ppe/QL_USB_Keyboard/eagle/QL_keyboard.brd

## EAGLE design eagle/QL_keyboard.brd (2016-05-03)

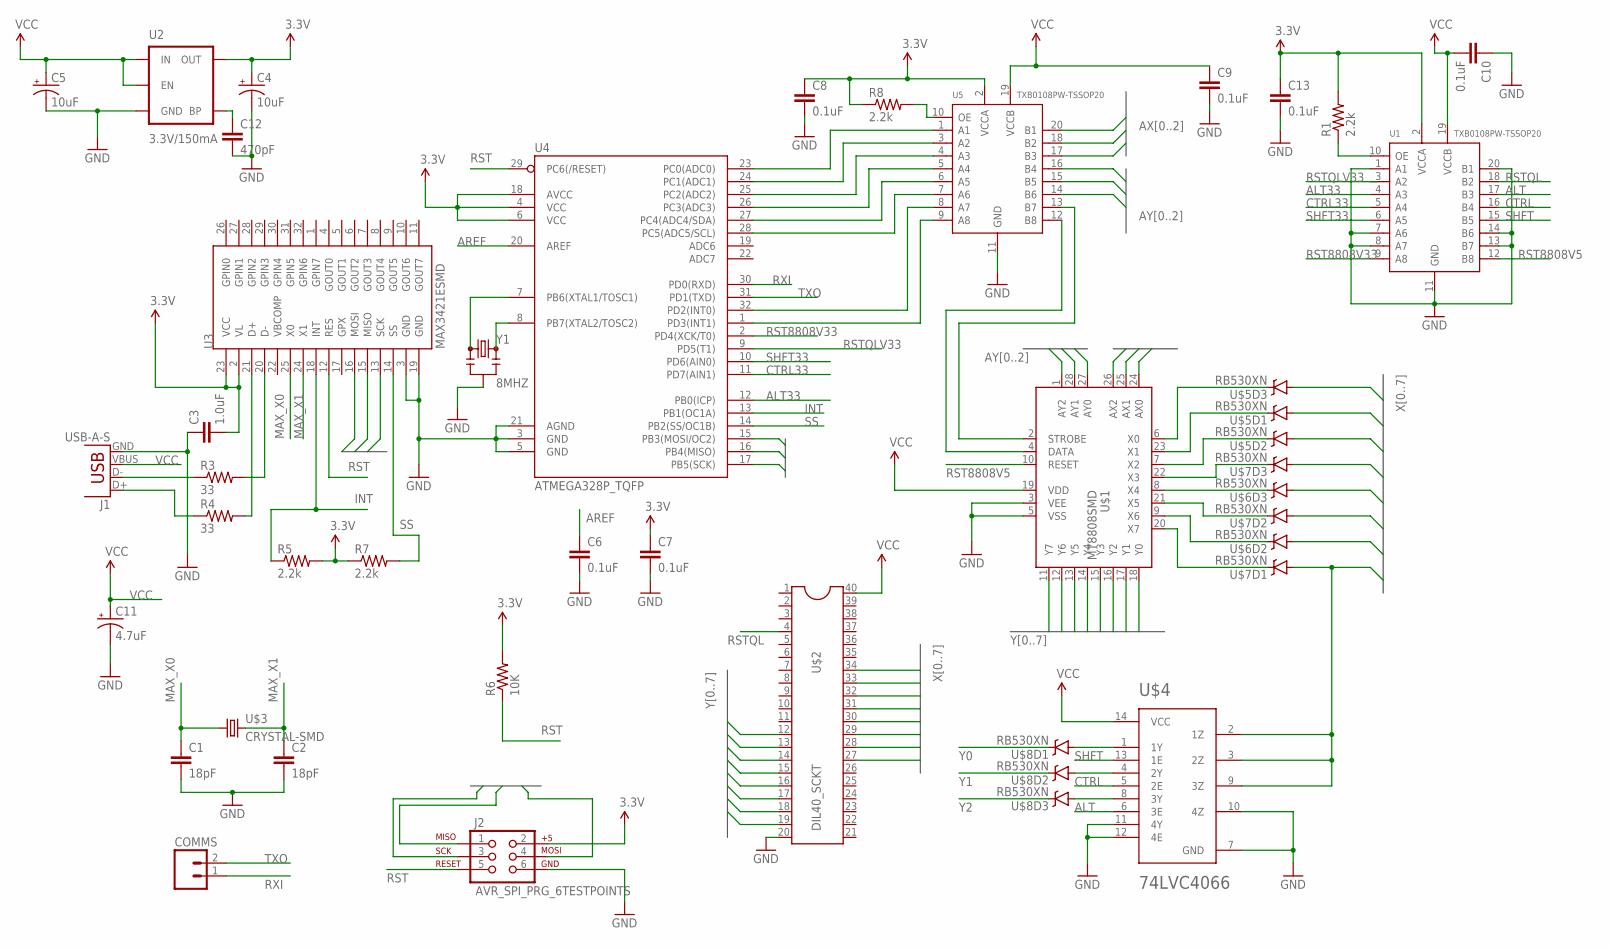
[picture p1: schematic QL_keyboard.sch]

Parts:
C1, C2: 18pF; 0603-CAP
C3: 1.0uF; 0603-CAP
C4, C5: 10uF; EIA3216
C6, C7, C8, C9, C10, C13: 0.1uF; 0603-CAP
C11: 4.7uF; 0603-POL
C12: 470pF; 0603-CAP
COMMS: M02PTH; 1X02
J1: USB-A-S
J2: AVR_SPI_PRG_6TESTPOINTS; 2X3_TEST_POINTS
R1, R5, R7, R8: 2.2k; 0603-RES
R3, R4: 33; 0603-RES
R6: 10K; 0603-RES
U1, U5: TXB0108PW-TSSOP20; TSSOP20-0.65-6.5X4.4MM
U2: 3.3V/150mA; SOT23-5
U3: MAX3421ESMD; TQFP32-5MM
U4: ATMEGA328P_TQFP; TQFP32-08
U$1: MT8808SMD; PLCC28S
U$2: DIL40_SCKT; DIL40
U$3: CRYSTAL-SMD; CRYSTAL-SMD-5X3.2
U$4: 74LVC4066; TSSOP14
U$5, U$6, U$7, U$8: RB530XN; SOT363
Y1: 8MHZ; RESONATOR-SMD

Connections:
3.3V: C3.2, C4.A (+), C7.1, C8.1, C13.1, J2.2, R1.2, R5.2, R6.2, R7.1, R8.1, U1.2 (VCCA), U2.5 (OUT), U3.2 (VL), U3.23 (VCC), U4.4 (VCC), U4.6 (VCC), U4.18 (AVCC), U5.2 (VCCA)
ALT: U1.17 (B3), U$4.6 (3E)
ALT33: U1.4 (A3), U4.12 (PB0(ICP))
AREF: C6.1, U4.20 (AREF)
AX0: U5.20 (B1), U$1.24 (AX0)
AX1: U5.18 (B2), U$1.25 (AX1)
AX2: U5.17 (B3), U$1.26 (AX2)
AY0: U5.16 (B4), U$1.27 (AY0)
AY1: U5.15 (B5), U$1.28 (AY1)
AY2: U5.14 (B6), U$1.1 (AY2)
CTRL: U1.16 (B4), U$4.5 (2E)
CTRL33: U1.5 (A4), U4.11 (PD7(AIN1))
GND: C1.2, C2.2, C3.1, C4.C (-), C5.C (-), C6.2, C7.2, C8.2, C9.2, C10.1, C11.K (-), C12.2, C13.2, J1.GND, J2.6, U1.1 (A1), U1.7 (A6), U1.8 (A7), U1.11 (GND), U1.13 (B7), U1.14 (B6), U1.20 (B1), U2.2 (GND), U3.3 (GND), U3.19 (GND), U4.3 (GND), U4.5 (GND), U4.21 (AGND), U5.11 (GND), U$1.3 (VEE), U$1.5 (VSS), U$2.20, U$4.7 (GND), U$4.10 (4Z), U$4.11 (4Y), U$4.12 (4E), Y1.2
INT: R5.1, U3.18 (INT), U4.13 (PB1(OC1A))
MAX_X0: C1.1, U3.25 (X0), U$3.1
MAX_X1: C2.1, U3.24 (X1), U$3.2
MISO: J2.1, U3.15 (MISO), U4.16 (PB4(MISO))
MOSI: J2.4, U3.16 (MOSI), U4.15 (PB3(MOSI/OC2))
unnamed: J1.D-, R3.1
unnamed: R3.2, U3.20 (D-)
unnamed: R4.2, U3.21 (D+)
unnamed: J1.D+, R4.1
unnamed: C12.1, U2.4 (BP)
unnamed: U4.23 (PC0(ADC0)), U5.1 (A1)
unnamed: U4.24 (PC1(ADC1)), U5.3 (A2)
unnamed: U4.25 (PC2(ADC2)), U5.4 (A3)
unnamed: U4.26 (PC3(ADC3)), U5.5 (A4)
unnamed: U4.27 (PC4(ADC4/SDA)), U5.6 (A5)
unnamed: U4.28 (PC5(ADC5/SCL)), U5.7 (A6)
unnamed: U4.32 (PD2(INT0)), U5.8 (A7)
unnamed: U5.12 (B8), U$1.4 (DATA)
unnamed: U5.13 (B7), U$1.2 (STROBE)
unnamed: U4.8 (PB7(XTAL2/TOSC2)), Y1.3
unnamed: U4.7 (PB6(XTAL1/TOSC1)), Y1.1
unnamed: R8.2, U5.10 (OE)
unnamed: U4.1 (PD3(INT1)), U5.9 (A8)
unnamed: U$1.6 (X0), U$5.3 (C)
unnamed: U$1.23 (X1), U$5.1 (C)
unnamed: U$1.7 (X2), U$5.2 (C)
unnamed: U$1.22 (X3), U$7.3 (C)
unnamed: U$1.8 (X4), U$6.3 (C)
unnamed: U$1.21 (X5), U$7.2 (C)
unnamed: U$1.9 (X6), U$6.2 (C)
unnamed: U$1.20 (X7), U$7.1 (C)
unnamed: U$4.1 (1Y), U$8.6 (A)
unnamed: U$4.4 (2Y), U$8.5 (A)
unnamed: U$4.8 (3Y), U$8.4 (A)
unnamed: R1.1, U1.10 (OE)
RST: J2.5, R6.1, U3.12 (RES), U4.29 (PC6(/RESET))
RST8808V5: U1.12 (B8), U$1.10 (RESET)
RST8808V33: U1.9 (A8), U4.2 (PD4(XCK/T0))
RSTQL: U1.18 (B2), U$2.4
RSTQLV33: U4.9 (PD5(T1))
RXI: COMMS.1, U4.30 (PD0(RXD))
SCK: J2.3, U3.13 (SCK), U4.17 (PB5(SCK))
SHFT: U1.15 (B5), U$4.13 (1E)
SHFT33: U1.6 (A5), U4.10 (PD6(AIN0))
SS: R7.2, U3.14 (SS), U4.14 (PB2(SS/OC1B))
TXO: COMMS.2, U4.31 (PD1(TXD))
VCC: C5.A (+), C9.1, C10.2, C11.A (+), J1.VBUS, U1.19 (VCCB), U2.1 (IN), U2.3 (EN), U5.19 (VCCB), U$1.19 (VDD), U$2.40, U$4.14 (VCC)
X0: U$2.27, U$5.4 (A)
X1: U$2.28, U$5.6 (A)
X2: U$2.29, U$5.5 (A)
X3: U$2.30, U$7.4 (A)
X4: U$2.31, U$6.4 (A)
X5: U$2.32, U$7.5 (A)
X6: U$2.33, U$6.5 (A)
X7: U$2.34, U$4.2 (1Z), U$4.3 (2Z), U$4.9 (3Z), U$7.6 (A)
Y0: U$1.18 (Y0), U$2.12, U$8.1 (C)
Y1: U$1.17 (Y1), U$2.13, U$8.2 (C)
Y2: U$1.16 (Y2), U$2.14, U$8.3 (C)
Y3: U$1.15 (Y3), U$2.15
Y4: U$1.14 (Y4), U$2.16
Y5: U$1.13 (Y5), U$2.17
Y6: U$1.12 (Y6), U$2.18
Y7: U$1.11 (Y7), U$2.19

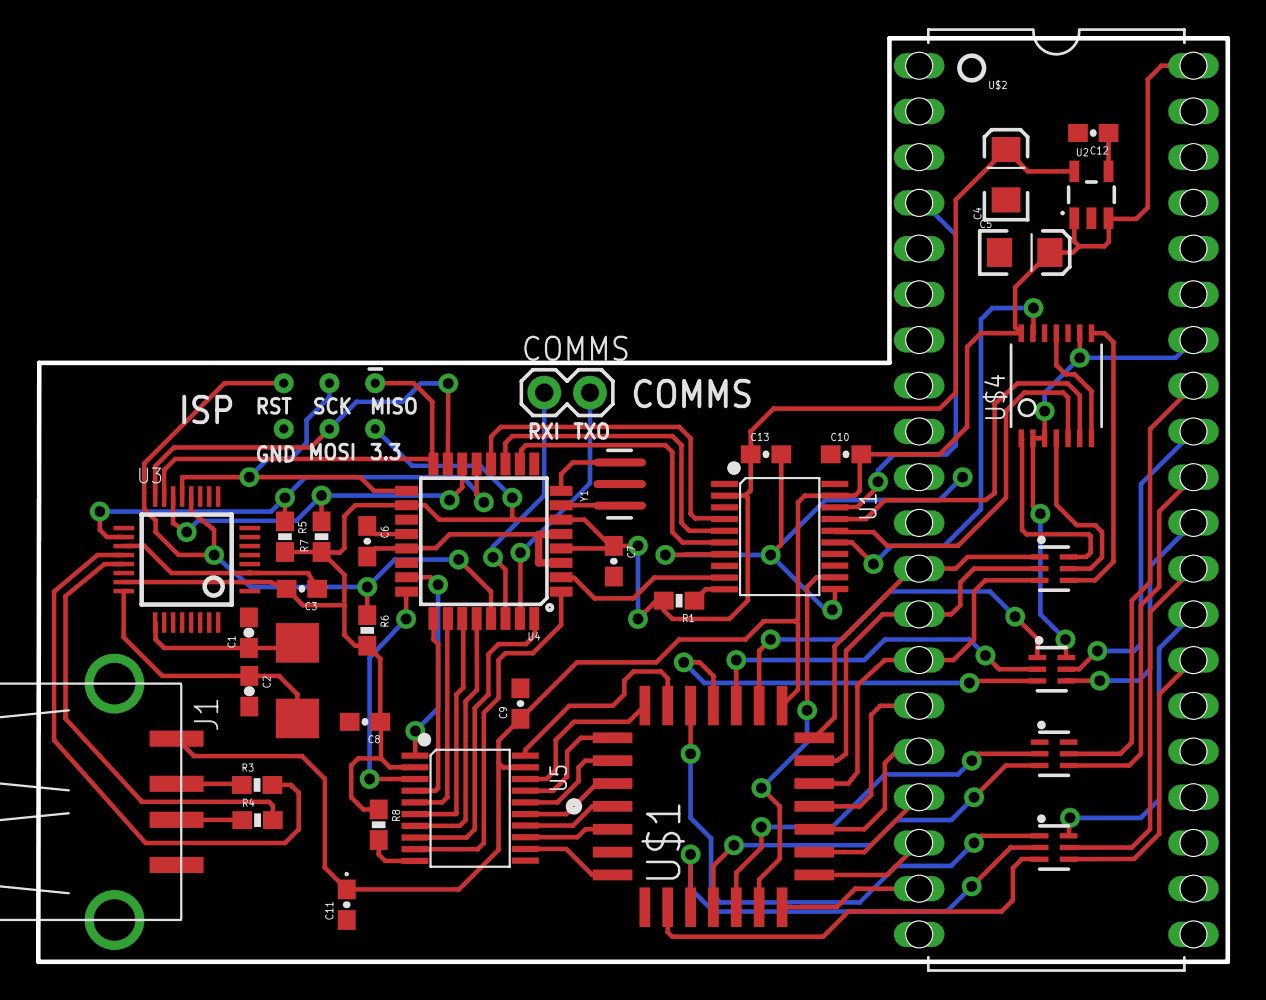
[picture p2: board QL_keyboard.brd from above]

Board: 2 copper layers, 66.1 x 51.3 mm, 37 parts (0 on the bottom side), 75 nets.
