ppe/QL_USB_Keyboard/(commit log)

2016-02-26 First layout version
    [QL_keyboard.brd, QL_keyboard.sch]
2016-02-26 WIP test atmega rotation
    [QL_keyboard.brd]
2016-02-26 WIP second layout version
    [QL_keyboard.brd, QL_keyboard.sch]
2016-02-26 Second, more compact, version of board.
    [QL_keyboard.brd]
2016-02-26 Add bottom silk screen text.
    [QL_keyboard.brd]
2016-02-26 Parameterize CAM job to use name of board in files.
2016-02-26 Add gerber files to ignore
2016-02-26 Move Eagle files to own directory
    [QL_keyboard.brd, QL_keyboard.sch]
2016-02-26 Add atmega driver
2016-02-26 Add github info on bottom silk.
    [QL_keyboard.brd]
2016-02-26 Move trace near edge of board
    [QL_keyboard.brd]
2016-02-26 Move diodes out of the way of DIL socket frame
    [QL_keyboard.brd]
2016-03-05 Change pin/port mappings to match revised hardware
2016-03-21 Fix bug in MT8808 VEE connection: connect to GND instead of VCC
    [QL_keyboard.brd, QL_keyboard.sch]
2016-03-21 Minor layout change
    [QL_keyboard.brd]
2016-03-26 Change MT8808 package to SMD PLCC28 holder.
    [QL_keyboard.brd, QL_keyboard.sch]
2016-03-26 Replace FTDI header with a two pin RXI/TXO header.
    [QL_keyboard.brd, QL_keyboard.sch]
2016-03-26 Move ISP header and fix USB connector footprint
    [QL_keyboard.brd, QL_keyboard.sch]
2016-03-26 General cleanup of layout
    [QL_keyboard.brd, QL_keyboard.sch]
2016-03-28 Add QL reset logic with voltage level shifting.
    [QL_keyboard.brd, QL_keyboard.sch]
2016-04-02 Minor routing adjustments
    [QL_keyboard.brd, QL_keyboard.sch]
2016-04-02 Change gitignore so that Gerber files are also tracked
2016-04-02 Add rendered Gerber files to project
    [QL_keyboard.GBL, QL_keyboard.GBO, QL_keyboard.GBS, QL_keyboard.GTL, QL_keyboard.GTO, QL_keyboard.GTP, QL_keyboard.GTS]
2016-05-03 Minor routing change in board.
    [QL_keyboard.brd]
2021-10-06 Add comment about probable bug
    [USB_keyboard.ino]
