ppe/QL_USB_Keyboard/(notices)

Notices in the files:
eagle/QL_keyboard.brd:
(c) 2016 Petri Pellinen
parts and their libraries:
SparkFun-Passives: Licensing: Creative Commons ShareAlike 4.0 International - https://creativecommons.org/licenses/by-sa/4.0
